cracked-machine/GuitarPLLSynthEffect/GuitarPLLSynthEffect.kicad_pcb

## KiCad design GuitarPLLSynthEffect.kicad_pcb (2018-05-30)

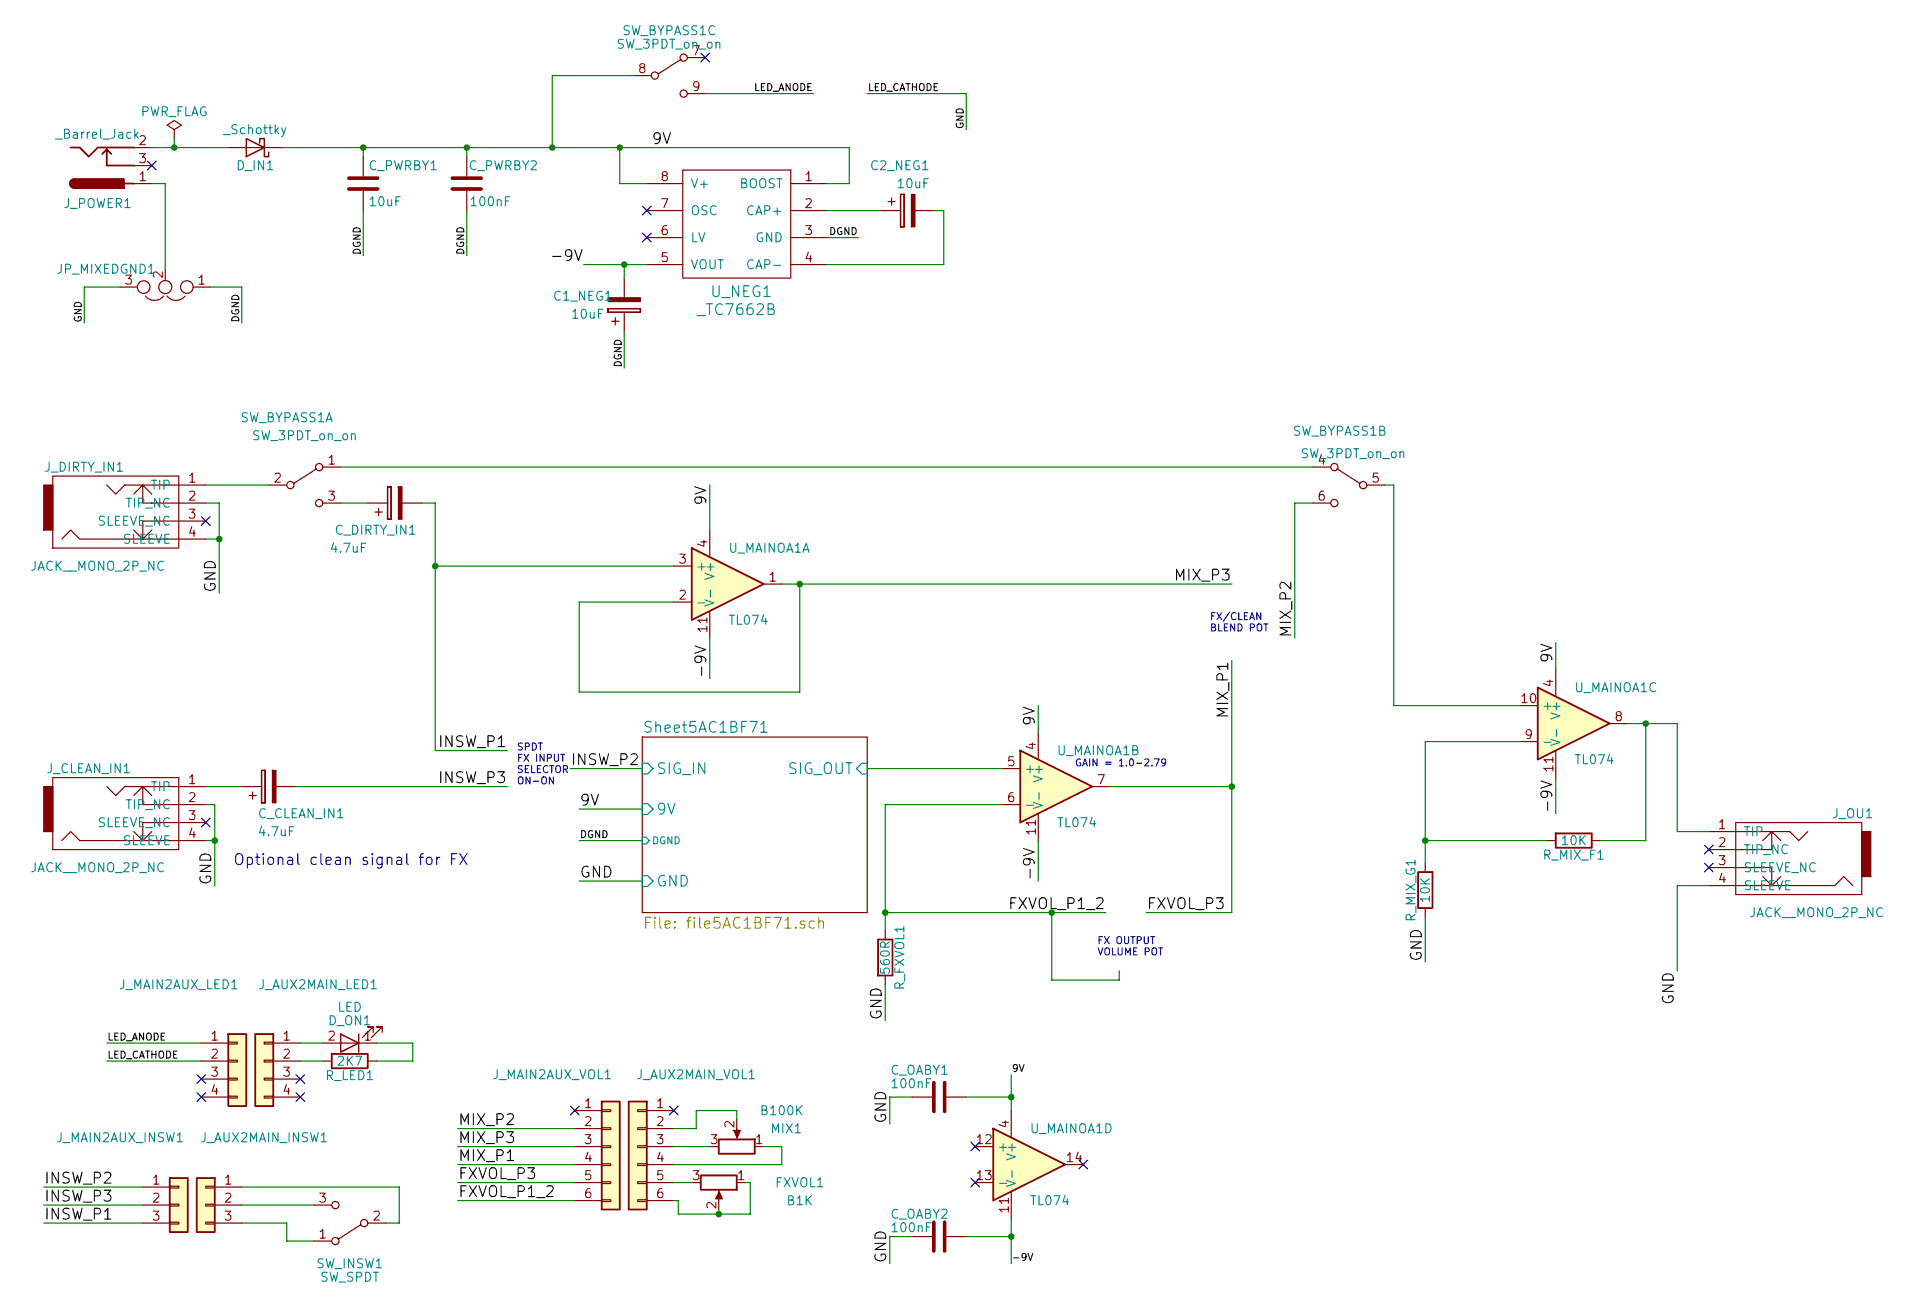
[picture p3: schematic GuitarPLLSynthEffect.sch, PLL Synth Effects Pedal]

Parts:
C1_NEG1, C2_NEG1: 10uF; CP_Elec_4x5.3
C_CLEAN_IN1: 4.7uF; C_0805_HandSoldering
C_DIRTY_IN1: 4.7uF; C_0805_HandSoldering
C_OABY1, C_OABY2: 100nF; C_0805_HandSoldering
C_PWRBY1: 10uF; CP_Elec_4x5.3
C_PWRBY2: 100nF; C_0805_HandSoldering
D_IN1: _Schottky; D_SOD-123F
D_ON1: LED; LED_D5.0mm
FXVOL1: B1K; Potentiometer_Bourns_PTV09A-1_Horizontal
JP_MIXEDGND1: Jumper_NC_Dual; NetTie-II_Connected_SMD
J_AUX2MAIN_INSW1: Conn_01x03; Pin_Header_Straight_1x03_Pitch2.54mm
J_AUX2MAIN_LED1: Conn_01x04; Pin_Header_Straight_1x04_Pitch2.54mm
J_AUX2MAIN_VOL1: Conn_01x06; Pin_Header_Straight_1x06_Pitch2.54mm
J_CLEAN_IN1: JACK__MONO_2P_NC; JackSocket_Mono_PCB
J_DIRTY_IN1: JACK__MONO_2P_NC; JackSocket_Mono_PCB
J_MAIN2AUX_INSW1: Conn_01x03; Pin_Header_Straight_1x03_Pitch2.54mm
J_MAIN2AUX_LED1: Conn_01x04; Pin_Header_Straight_1x04_Pitch2.54mm
J_MAIN2AUX_VOL1: Conn_01x06; Pin_Header_Straight_1x06_Pitch2.54mm
J_OU1: JACK__MONO_2P_NC; JackSocket_Mono_PCB
J_POWER1: _Barrel_Jack; BARREL_JACK
MIX1: B100K; Potentiometer_Bourns_PTV09A-1_Horizontal
R_FXVOL1: 560R; R_0805_HandSoldering
R_LED1: 2K7; R_0805_HandSoldering
R_MIX_F1: 10K; R_0805_HandSoldering
R_MIX_G1: 10K; R_0805_HandSoldering
SW_BYPASS1: SW_3PDT_on_on; SW_3PDT_W18MM_L17.3MM_P5.3MM_D2MM_PCBPin
SW_INSW1: SW_SPDT; SW_SPDT_W6.86MM_L12.7MM_P4.8MM_D2MM
U_MAINOA1: TL074; SOIC-14_N
U_NEG1: _TC7662B; SOIC-8-N

Connections:
/9V: C_OABY1.1, C_PWRBY1.1, C_PWRBY2.2, D_IN1.1 (K), SW_BYPASS1.8 (B), U_MAINOA1.4 (V+), U_NEG1.1 (BOOST), U_NEG1.8 (V+); also elsewhere on the board
/-9V: C1_NEG1.2, C_OABY2.1, U_MAINOA1.11 (V-), U_NEG1.5 (VOUT)
/DGND: C1_NEG1.1, C_PWRBY1.2, C_PWRBY2.1, JP_MIXEDGND1.1, U_NEG1.3 (GND); also elsewhere on the board
/FXVOL_P1_2: J_MAIN2AUX_VOL1.6, R_FXVOL1.1, U_MAINOA1.6 (-)
/FXVOL_P3: J_MAIN2AUX_VOL1.4, J_MAIN2AUX_VOL1.5, U_MAINOA1.7
/GND: C_OABY1.2, C_OABY2.2, JP_MIXEDGND1.3, J_CLEAN_IN1.2 (TIP_NC), J_CLEAN_IN1.4 (SLEEVE), J_DIRTY_IN1.2 (TIP_NC), J_DIRTY_IN1.4 (SLEEVE), J_MAIN2AUX_LED1.2, J_OU1.4 (SLEEVE), R_FXVOL1.2, R_MIX_G1.1; also elsewhere on the board
/INSW_P1: C_DIRTY_IN1.2, J_MAIN2AUX_INSW1.3, U_MAINOA1.3 (+)
/INSW_P2: J_MAIN2AUX_INSW1.1; also elsewhere on the board
/INSW_P3: C_CLEAN_IN1.2, J_MAIN2AUX_INSW1.2
/LED_ANODE: J_MAIN2AUX_LED1.1, SW_BYPASS1.9 (C)
/MIX_P2: J_MAIN2AUX_VOL1.2, SW_BYPASS1.6 (C)
/MIX_P3: J_MAIN2AUX_VOL1.3, U_MAINOA1.1, U_MAINOA1.2 (-)
/Sheet5AC1BF71/SIG_OUT: U_MAINOA1.5 (+); also elsewhere on the board
unnamed: C2_NEG1.1, U_NEG1.2 (CAP+)
unnamed: C2_NEG1.2, U_NEG1.4 (CAP-)
unnamed: C_CLEAN_IN1.1, J_CLEAN_IN1.1 (TIP)
unnamed: C_DIRTY_IN1.1, SW_BYPASS1.3 (C)
unnamed: D_IN1.2 (A), J_POWER1.2
unnamed: D_ON1.1 (K), R_LED1.1
unnamed: D_ON1.2 (A), J_AUX2MAIN_LED1.1
unnamed: FXVOL1.1, FXVOL1.2, J_AUX2MAIN_VOL1.6
unnamed: FXVOL1.3, J_AUX2MAIN_VOL1.5
unnamed: JP_MIXEDGND1.2, J_POWER1.1
unnamed: J_AUX2MAIN_INSW1.1, SW_INSW1.2 (B)
unnamed: J_AUX2MAIN_INSW1.2, SW_INSW1.3 (C)
unnamed: J_AUX2MAIN_INSW1.3, SW_INSW1.1 (A)
unnamed: J_AUX2MAIN_LED1.2, R_LED1.2
unnamed: J_AUX2MAIN_VOL1.2, MIX1.2
unnamed: J_AUX2MAIN_VOL1.3, MIX1.3
unnamed: J_AUX2MAIN_VOL1.4, MIX1.1
unnamed: J_DIRTY_IN1.1 (TIP), SW_BYPASS1.2 (B)
unnamed: J_OU1.1 (TIP), R_MIX_F1.1, U_MAINOA1.8
unnamed: R_MIX_F1.2, R_MIX_G1.2, U_MAINOA1.9 (-)
unnamed: SW_BYPASS1.1 (A), SW_BYPASS1.4 (A)
unnamed: SW_BYPASS1.5 (B), U_MAINOA1.10 (+)

Notes on the sheet:
GAIN = 1.0-2.79
Optional clean signal for FX
SPDT FX INPUT SELECTOR ON-ON
FX OUTPUT VOLUME POT
FX/CLEAN BLEND POT

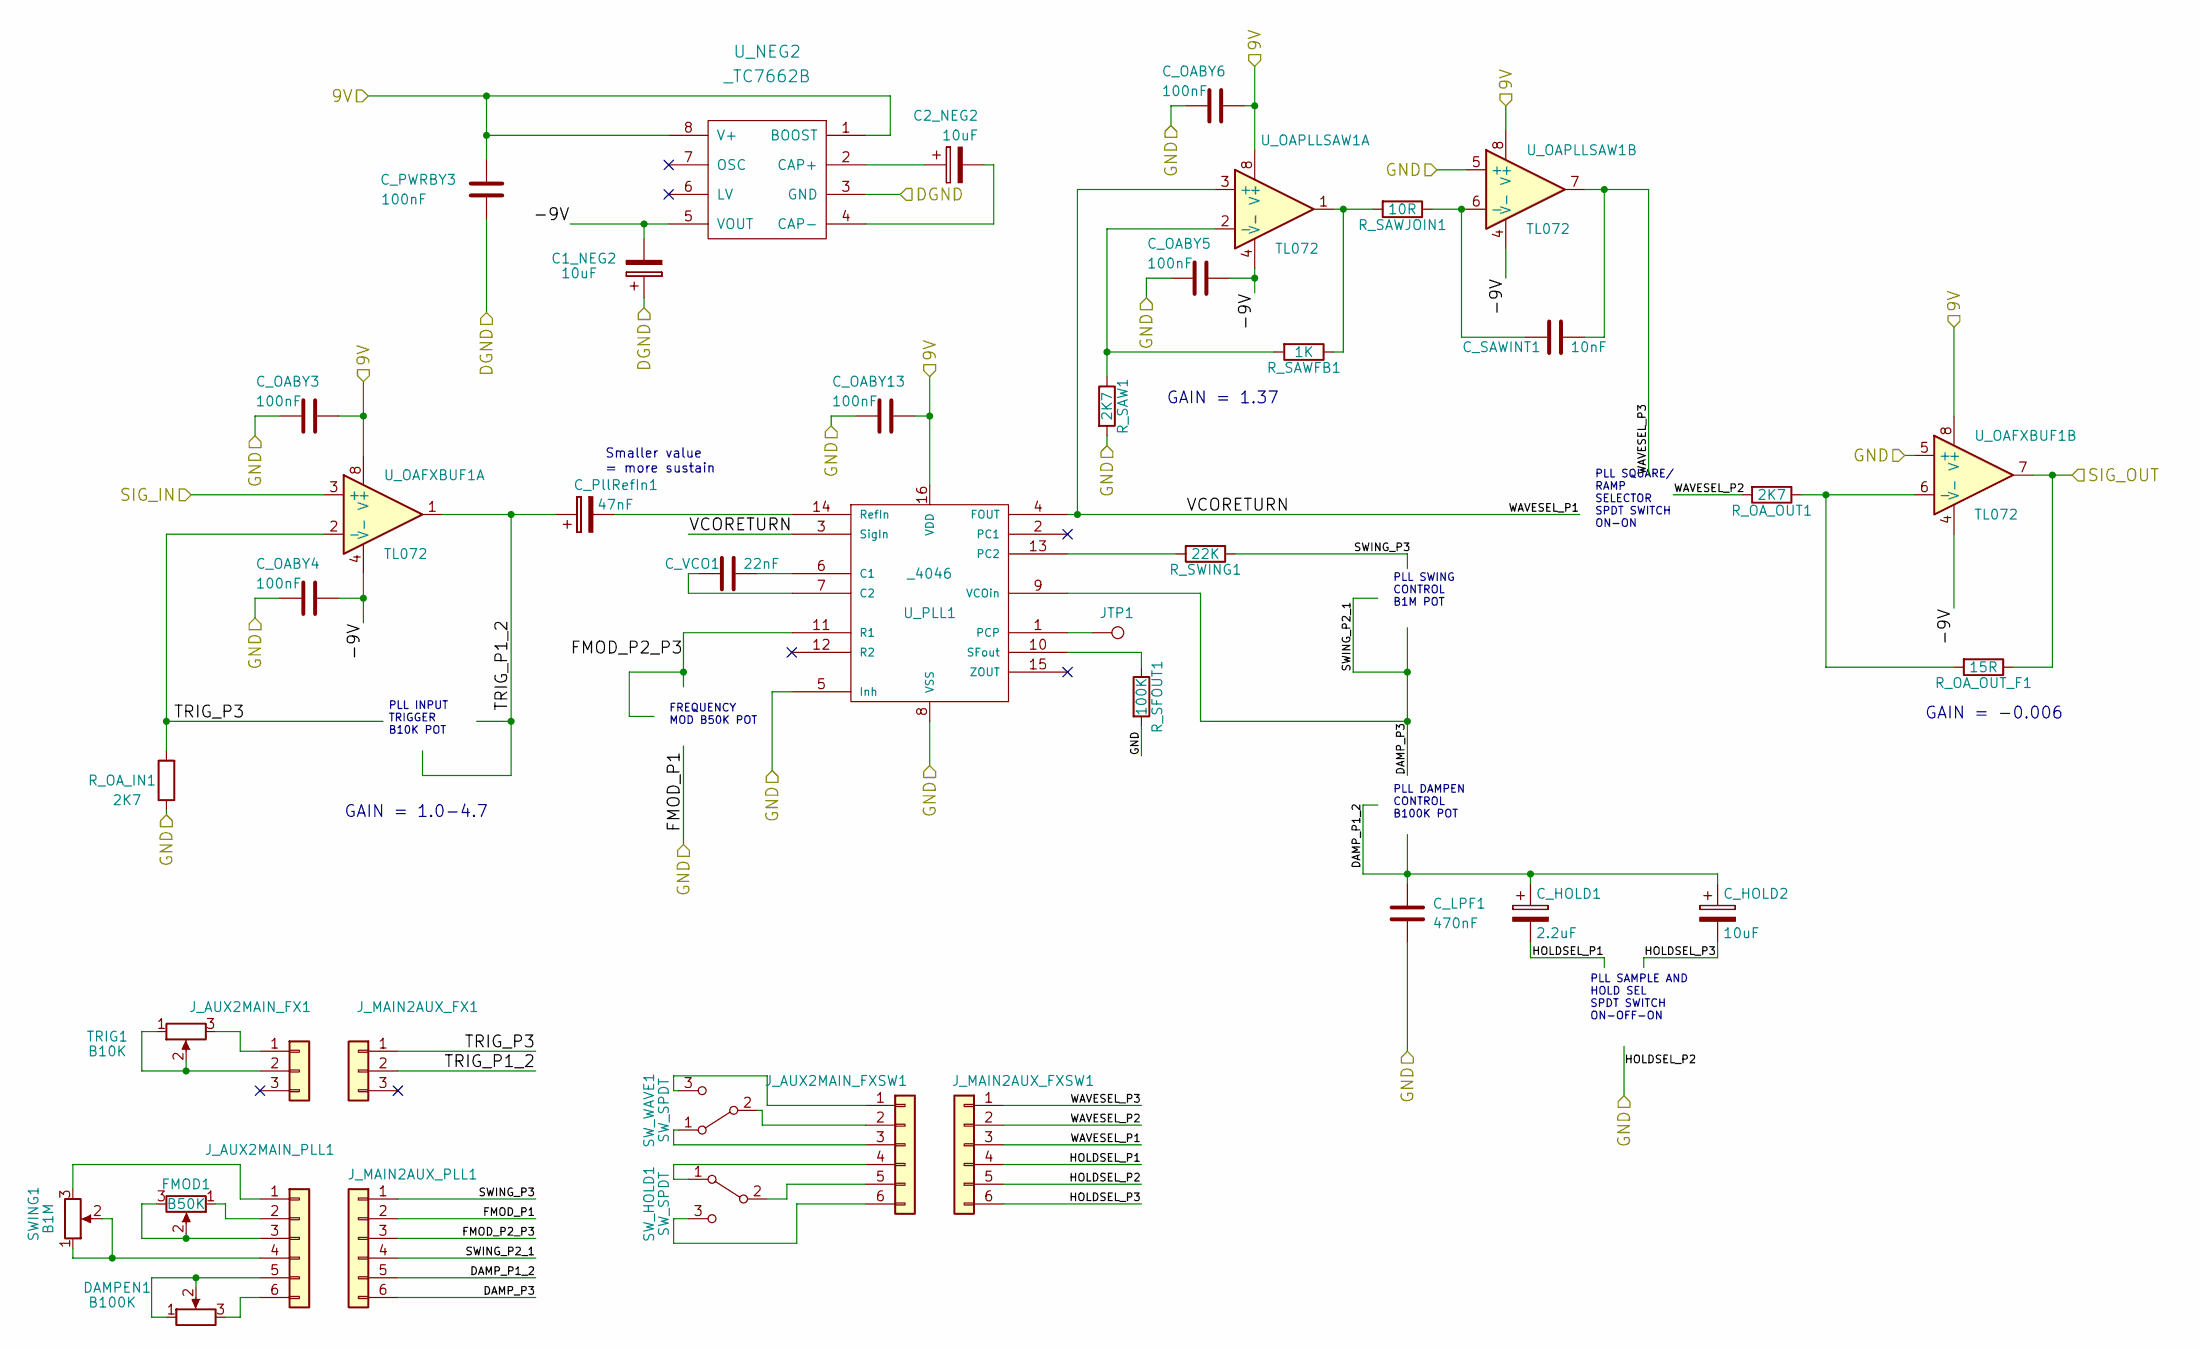
[picture p4: schematic file5AC1BF71.sch, PLL Synth Effects Pedal]

Parts:
C1_NEG2, C2_NEG2: 10uF; CP_Elec_4x5.3
C_HOLD1: 2.2uF; C_0805_HandSoldering
C_HOLD2: 10uF; C_0805_HandSoldering
C_LPF1: 470nF; C_0805_HandSoldering
C_OABY3, C_OABY4, C_OABY5, C_OABY6, C_OABY13: 100nF; C_0805_HandSoldering
C_PWRBY3: 100nF; C_0805_HandSoldering
C_PllRefIn1: 47nF; C_0805_HandSoldering
C_SAWINT1: 10nF; C_0805_HandSoldering
C_VCO1: 22nF; C_0805_HandSoldering
DAMPEN1: B100K; Potentiometer_Bourns_PTV09A-1_Horizontal
FMOD1: B50K; Potentiometer_Bourns_PTV09A-1_Horizontal
JTP1: TEST_1P; Measurement_Point_Round-SMD-Pad_Small
J_AUX2MAIN_FX1: Conn_01x03; Pin_Header_Straight_1x03_Pitch2.54mm
J_AUX2MAIN_FXSW1, J_AUX2MAIN_PLL1: Conn_01x06; Pin_Header_Straight_1x06_Pitch2.54mm
J_MAIN2AUX_FX1: Conn_01x03; Pin_Header_Straight_1x03_Pitch2.54mm
J_MAIN2AUX_FXSW1, J_MAIN2AUX_PLL1: Conn_01x06; Pin_Header_Straight_1x06_Pitch2.54mm
R_OA_IN1: 2K7; R_0805_HandSoldering
R_OA_OUT1: 2K7; R_0805_HandSoldering
R_OA_OUT_F1: 15R; R_0805_HandSoldering
R_SAW1: 2K7; R_0805_HandSoldering
R_SAWFB1: 1K; R_0805_HandSoldering
R_SAWJOIN1: 10R; R_0805_HandSoldering
R_SFOUT1: 100K; R_0805_HandSoldering
R_SWING1: 22K; R_0805_HandSoldering
SWING1: B1M; Potentiometer_Bourns_PTV09A-1_Horizontal
SW_HOLD1: SW_SPDT; SW_SPDT_W6.86MM_L12.7MM_P4.8MM_D2MM
SW_WAVE1: SW_SPDT; SW_SPDT_W6.86MM_L12.7MM_P4.8MM_D2MM
TRIG1: B10K; Potentiometer_Bourns_PTV09A-1_Horizontal
U_NEG2: _TC7662B; SOIC-8-N
U_OAFXBUF1: TL072; SOIC-8-N
U_OAPLLSAW1: TL072; SOIC-8-N
U_PLL1: _4046; SO-16-N++

Connections:
/9V: C_OABY3.1, C_OABY6.1, C_OABY13.1, C_PWRBY3.2, U_NEG2.1 (BOOST), U_NEG2.8 (V+), U_OAFXBUF1.8 (V+), U_OAPLLSAW1.8 (V+), U_PLL1.16 (VDD); also elsewhere on the board
/DGND: C1_NEG2.1, C_PWRBY3.1, U_NEG2.3 (GND); also elsewhere on the board
/GND: C_LPF1.2, C_OABY3.2, C_OABY4.2, C_OABY5.2, C_OABY6.2, C_OABY13.2, J_MAIN2AUX_FXSW1.5, J_MAIN2AUX_PLL1.2, R_OA_IN1.1, R_SAW1.2, R_SFOUT1.2, U_OAFXBUF1.5 (+), U_OAPLLSAW1.5 (+), U_PLL1.5 (Inh), U_PLL1.8 (VSS); also elsewhere on the board
/INSW_P2: U_OAFXBUF1.3 (+); also elsewhere on the board
/Sheet5AC1BF71/-9V: C1_NEG2.2, C_OABY4.1, C_OABY5.1, U_NEG2.5 (VOUT), U_OAFXBUF1.4 (V-), U_OAPLLSAW1.4 (V-)
/Sheet5AC1BF71/DAMP_P1_2: C_HOLD1.1, C_HOLD2.1, C_LPF1.1, J_MAIN2AUX_PLL1.5
/Sheet5AC1BF71/DAMP_P3: J_MAIN2AUX_PLL1.4, J_MAIN2AUX_PLL1.6, U_PLL1.9 (VCOin)
/Sheet5AC1BF71/FMOD_P2_P3: J_MAIN2AUX_PLL1.3, U_PLL1.11 (R1)
/Sheet5AC1BF71/HOLDSEL_P1: C_HOLD1.2, J_MAIN2AUX_FXSW1.4
/Sheet5AC1BF71/HOLDSEL_P3: C_HOLD2.2, J_MAIN2AUX_FXSW1.6
/Sheet5AC1BF71/SIG_OUT: R_OA_OUT_F1.1, U_OAFXBUF1.7; also elsewhere on the board
/Sheet5AC1BF71/SWING_P3: J_MAIN2AUX_PLL1.1, R_SWING1.1
/Sheet5AC1BF71/TRIG_P1_2: C_PllRefIn1.1, J_MAIN2AUX_FX1.2, U_OAFXBUF1.1
/Sheet5AC1BF71/TRIG_P3: J_MAIN2AUX_FX1.1, R_OA_IN1.2, U_OAFXBUF1.2 (-)
/Sheet5AC1BF71/VCORETURN: J_MAIN2AUX_FXSW1.3, U_OAPLLSAW1.3 (+), U_PLL1.3 (SigIn), U_PLL1.4 (FOUT)
/Sheet5AC1BF71/WAVESEL_P2: J_MAIN2AUX_FXSW1.2, R_OA_OUT1.2
/Sheet5AC1BF71/WAVESEL_P3: C_SAWINT1.1, J_MAIN2AUX_FXSW1.1, U_OAPLLSAW1.7
unnamed: C2_NEG2.1, U_NEG2.2 (CAP+)
unnamed: C2_NEG2.2, U_NEG2.4 (CAP-)
unnamed: C_PllRefIn1.2, U_PLL1.14 (RefIn)
unnamed: C_SAWINT1.2, R_SAWJOIN1.1, U_OAPLLSAW1.6 (-)
unnamed: C_VCO1.1, U_PLL1.6 (C1)
unnamed: C_VCO1.2, U_PLL1.7 (C2)
unnamed: DAMPEN1.1, DAMPEN1.2, J_AUX2MAIN_PLL1.5
unnamed: DAMPEN1.3, J_AUX2MAIN_PLL1.6
unnamed: FMOD1.1, J_AUX2MAIN_PLL1.2
unnamed: FMOD1.2, FMOD1.3, J_AUX2MAIN_PLL1.3
unnamed: JTP1.1, U_PLL1.1 (PCP)
unnamed: J_AUX2MAIN_FX1.1, TRIG1.3
unnamed: J_AUX2MAIN_FX1.2, TRIG1.1, TRIG1.2
unnamed: J_AUX2MAIN_FXSW1.1, SW_WAVE1.3 (C)
unnamed: J_AUX2MAIN_FXSW1.2, SW_WAVE1.2 (B)
unnamed: J_AUX2MAIN_FXSW1.3, SW_WAVE1.1 (A)
unnamed: J_AUX2MAIN_FXSW1.4, SW_HOLD1.1 (A)
unnamed: J_AUX2MAIN_FXSW1.5, SW_HOLD1.2 (B)
unnamed: J_AUX2MAIN_FXSW1.6, SW_HOLD1.3 (C)
unnamed: J_AUX2MAIN_PLL1.1, SWING1.3
unnamed: J_AUX2MAIN_PLL1.4, SWING1.1, SWING1.2
unnamed: R_OA_OUT1.1, R_OA_OUT_F1.2, U_OAFXBUF1.6 (-)
unnamed: R_SAW1.1, R_SAWFB1.2, U_OAPLLSAW1.2 (-)
unnamed: R_SAWFB1.1, R_SAWJOIN1.2, U_OAPLLSAW1.1
unnamed: R_SFOUT1.1, U_PLL1.10 (SFout)
unnamed: R_SWING1.2, U_PLL1.13 (PC2)

Notes on the sheet:
Smaller value = more sustain
GAIN = -0.006
GAIN = 1.0-4.7
GAIN = 1.37
PLL INPUT TRIGGER B10K POT
FREQUENCY MOD B50K POT
PLL SWING CONTROL B1M POT
PLL DAMPEN CONTROL B100K POT
PLL SAMPLE AND HOLD SEL SPDT SWITCH ON-OFF-ON
PLL SQUARE/ RAMP SELECTOR SPDT SWITCH ON-ON

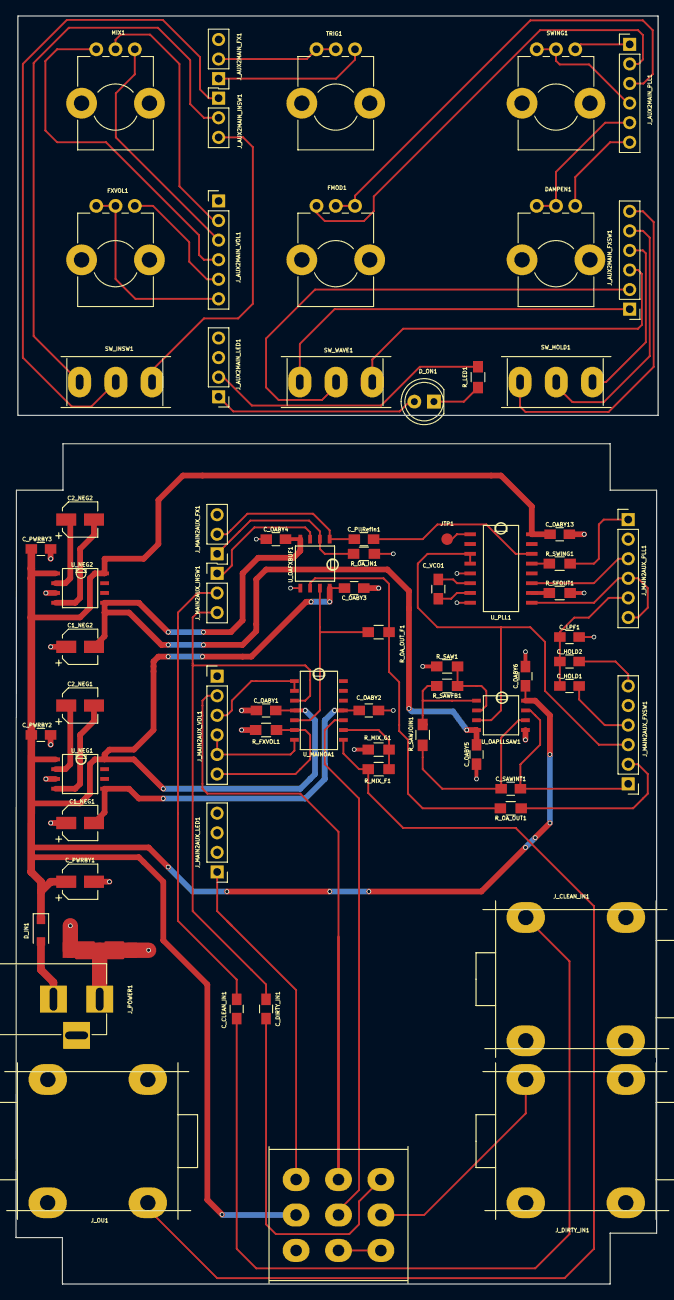
[picture p5: board GuitarPLLSynthEffect.kicad_pcb from above]

Board: 2 copper layers, 83.3 x 164.5 mm, 70 parts (0 on the bottom side), 73 nets.
