cracked-machine/GuitarPLLSynthEffect/(commit log)

2018-03-29 First Commit
    - Added basic schematic
    [GuitarPLLSynthEffect.kicad_pcb, GuitarPLLSynthEffect.sch]
2018-03-30 Schematic design update
    - Added PLL controls
    - Added dual power supply (TC7662B)
    - Added Output buffer OpAmp
    [GuitarPLLSynthEffect.sch]
2018-03-31 Schematic design update
    - Added fx trigger/gain control to OAFX_IN opamp
    - Added FM control to PLL
    - Added clean/fx summing opamp
    [GuitarPLLSynthEffect.sch, file5AC1BF71.sch]
2018-04-01 UPDATE
    ADDED FX OUPUT GAIN STAGE
    ADDED FX/CLEAN MIXER OPAMP (WITH SINGLE BLEND POT CONTROL)
    [GuitarPLLSynthEffect.sch, file5AC1BF71.sch]
2018-04-01 schematic design update
    Added saw wave
    [file5AC1BF71.sch]
2018-04-02 schematic design update
    Added clean signal input and selector switch (dirty signal will always go to mixer)
    [GuitarPLLSynthEffect.sch, file5AC1BF71.sch]
2018-04-02 Final RevA Schematic
    [GuitarPLLSynthEffect.csv, GuitarPLLSynthEffect.sch, file5AC1BF71.sch]
2018-04-03 Added board layout
    [file5AC1BF71.sch]
2018-04-03 Board Design Update RevA
    [GuitarPLLSynthEffect.kicad_pcb, GuitarPLLSynthEffect.sch, _saved_GuitarPLLSynthEffect.sch, file5AC1BF71.sch]
2018-04-03 Completed First Draft board Layout RevA
    [GuitarPLLSynthEffect.csv, GuitarPLLSynthEffect.kicad_pcb]
2018-04-04 Second draft PCB layout
    [GuitarPLLSynthEffect.csv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]
2018-04-05 Corrections to board dimensions, adjusted layout to fit
    [GuitarPLLSynthEffect.kicad_pcb, file5AC1BF71.sch]
2018-04-07 final layout
    [GuitarPLLSynthEffect-B.Cu.gbr, GuitarPLLSynthEffect-B.Mask.gbr, GuitarPLLSynthEffect-B.SilkS.gbr, GuitarPLLSynthEffect-Edge.Cuts.gbr, GuitarPLLSynthEffect-F.Cu.gbr, GuitarPLLSynthEffect-F.Mask.gbr, GuitarPLLSynthEffect-F.SilkS.gbr, GuitarPLLSynthEffect.drl]
2018-04-07 Layout design corrections
    [GuitarPLLSynthEffect-B.Cu.gbr, GuitarPLLSynthEffect-B.Mask.gbr, GuitarPLLSynthEffect-B.SilkS.gbr, GuitarPLLSynthEffect-Edge.Cuts.gbr, GuitarPLLSynthEffect-F.Cu.gbr, GuitarPLLSynthEffect-F.Mask.gbr, GuitarPLLSynthEffect-F.SilkS.gbr, GuitarPLLSynthEffect-NPTH.drl]
2018-04-08 layout updates
    [GuitarPLLSynthEffect-B.Cu.gbr, GuitarPLLSynthEffect-B.Mask.gbr, GuitarPLLSynthEffect-B.SilkS.gbr, GuitarPLLSynthEffect-Edge.Cuts.gbr, GuitarPLLSynthEffect-F.Cu.gbr, GuitarPLLSynthEffect-F.Mask.gbr, GuitarPLLSynthEffect-F.SilkS.gbr, GuitarPLLSynthEffect-NPTH.drl]
2018-04-08 layout update
    [GuitarPLLSynthEffect-B.Cu.gbr, GuitarPLLSynthEffect-B.Mask.gbr, GuitarPLLSynthEffect-B.SilkS.gbr, GuitarPLLSynthEffect-Edge.Cuts.gbr, GuitarPLLSynthEffect-F.Cu.gbr, GuitarPLLSynthEffect-F.Mask.gbr, GuitarPLLSynthEffect-F.SilkS.gbr, GuitarPLLSynthEffect-NPTH.drl]
2018-05-02 Board Layout updates
    - Increased PLL footprint width
    - Separated FX TL074 into 2 TL072's.
    [GuitarPLLSynthEffect.kicad_pcb, file5AC1BF71.sch]
2018-05-03 Board Layout redesign
    [GuitarPLLSynthEffect.kicad_pcb, file5AC1BF71.sch]
2018-05-06 Board Redesign - RevB
    - Created seperate ground plane for DC-DC Converters
    - Re-routed the rest of the board.
    [GuitarPLLSynthEffect-B.Cu.gbr, GuitarPLLSynthEffect-B.Mask.gbr, GuitarPLLSynthEffect-B.SilkS.gbr, GuitarPLLSynthEffect-Edge.Cuts.gbr, GuitarPLLSynthEffect-F.Cu.gbr, GuitarPLLSynthEffect-F.Mask.gbr, GuitarPLLSynthEffect-F.SilkS.gbr, GuitarPLLSynthEffect.drl]
2018-05-30 board correction
    [GuitarPLLSynthEffect.kicad_pcb]
